jessicasillus/Compliant-Gripper/Gripper Assembly/Assem2_ref_002.SLDASM

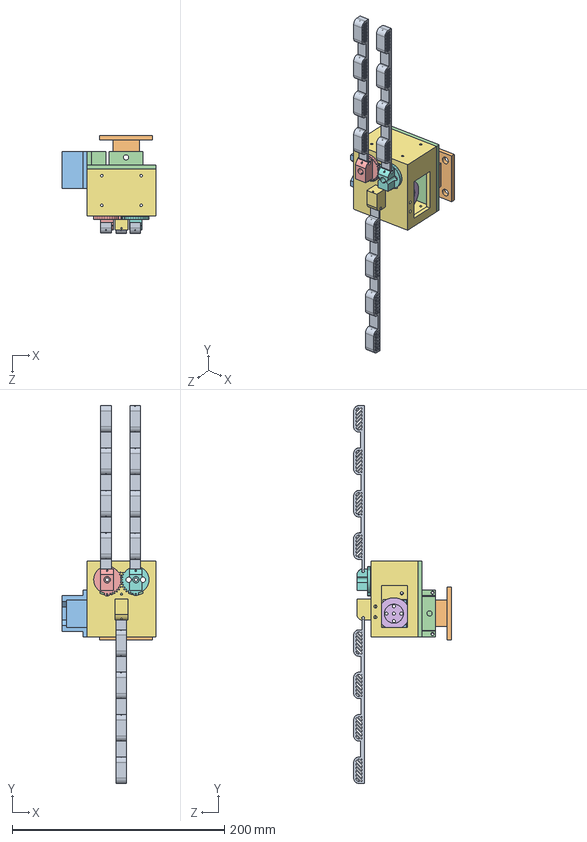
[picture p1: CAD file, 2026-03-13]
Gripper Assembly/Assem2_ref_002.SLDASM
88.6 x 356.5 x 92.1 mm
RightGear_002
Top_Box_002
Pulley_New_002
LeftGear_002
Bottom_Box_2_002
Bottom_Box_3_002
ur5eadapterplate
45degreefinger x 3
