jessicasillus/Compliant-Gripper/Gripper Assembly/RightGear_002.SLDPRT

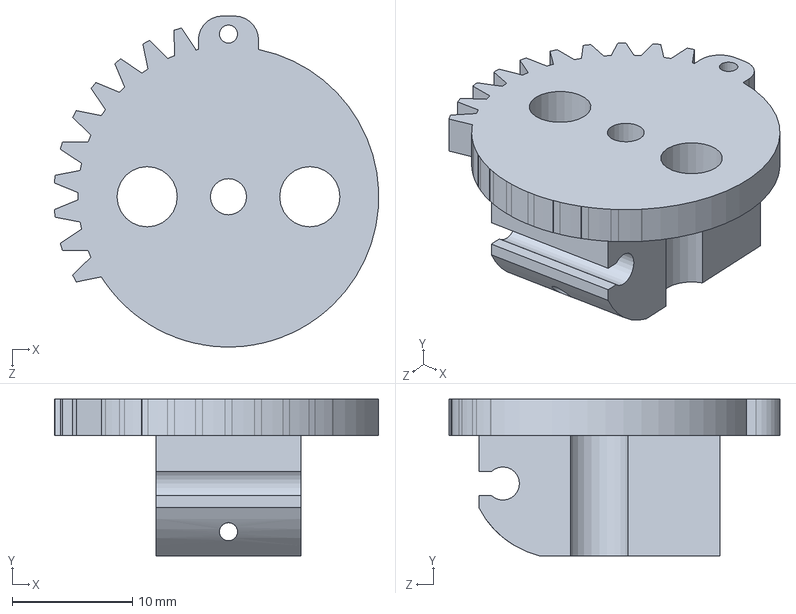
[picture p2: CAD file, 2026-03-13]
Gripper Assembly/RightGear_002.SLDPRT
26.9 x 13.0 x 27.5 mm
