jessicasillus/Compliant-Gripper/Gripper Assembly/Pulley_New_002.SLDPRT

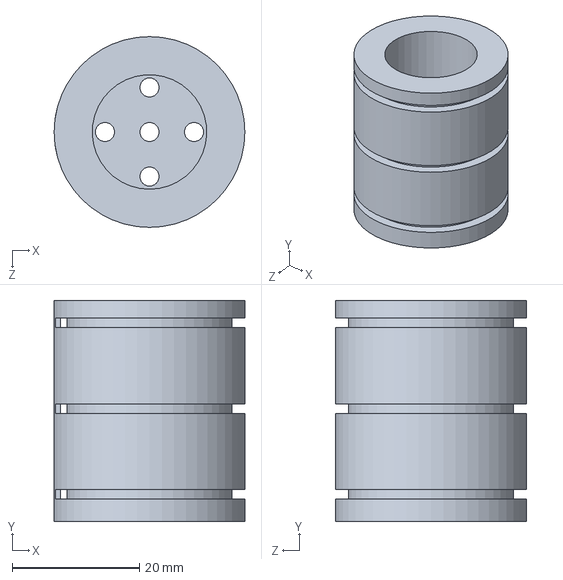
[picture p3: CAD file, 2026-03-13]
Gripper Assembly/Pulley_New_002.SLDPRT
30.0 x 34.8 x 30.0 mm
