jessicasillus/Compliant-Gripper/Gripper Assembly/45degreefinger.SLDPRT

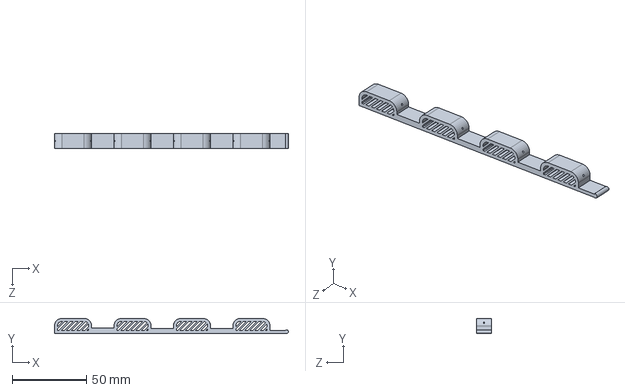
[picture p4: CAD file, 2026-03-13]
Gripper Assembly/45degreefinger.SLDPRT
157.4 x 10.2 x 10.0 mm
