jessicasillus/Compliant-Gripper/Gripper Assembly/LeftGear_002.SLDPRT

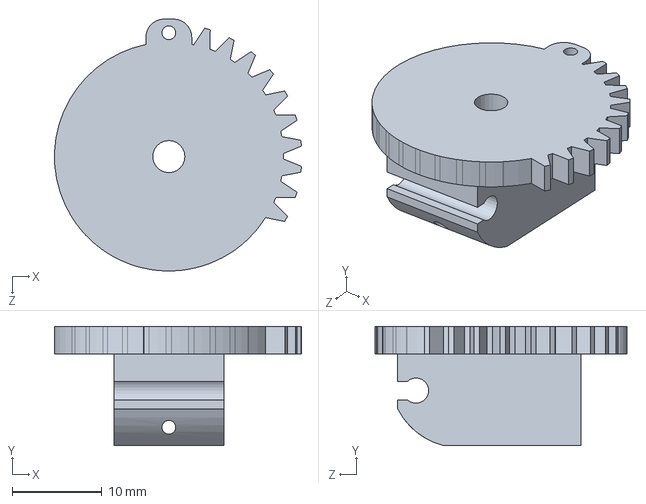
[picture p5: CAD file, 2026-03-13]
Gripper Assembly/LeftGear_002.SLDPRT
27.5 x 13.3 x 28.0 mm
