jessicasillus/Compliant-Gripper/Gripper Assembly/box_cover_002.SLDPRT

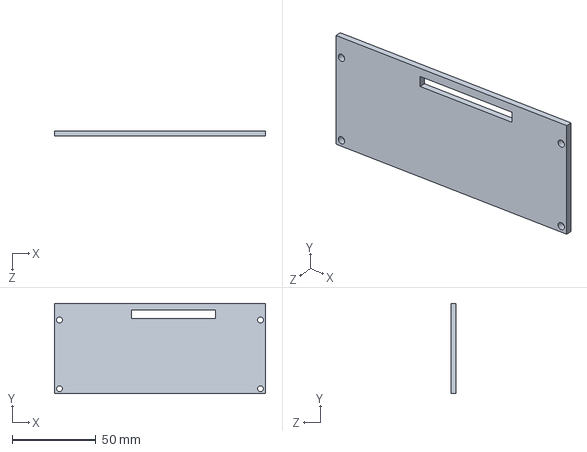
[picture p6: CAD file, 2026-03-13]
Gripper Assembly/box_cover_002.SLDPRT
126.0 x 54.0 x 3.00 mm
