jessicasillus/Compliant-Gripper/Gripper Assembly/Top_Box_002.SLDPRT

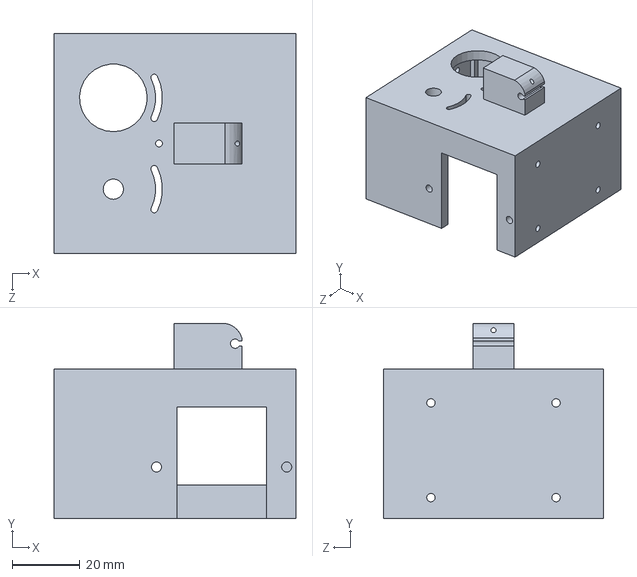
[picture p7: CAD file, 2026-03-13]
Gripper Assembly/Top_Box_002.SLDPRT
71.5 x 57.7 x 65.0 mm
