jessicasillus/Compliant-Gripper/Gripper Assembly/tendon_002.SLDPRT

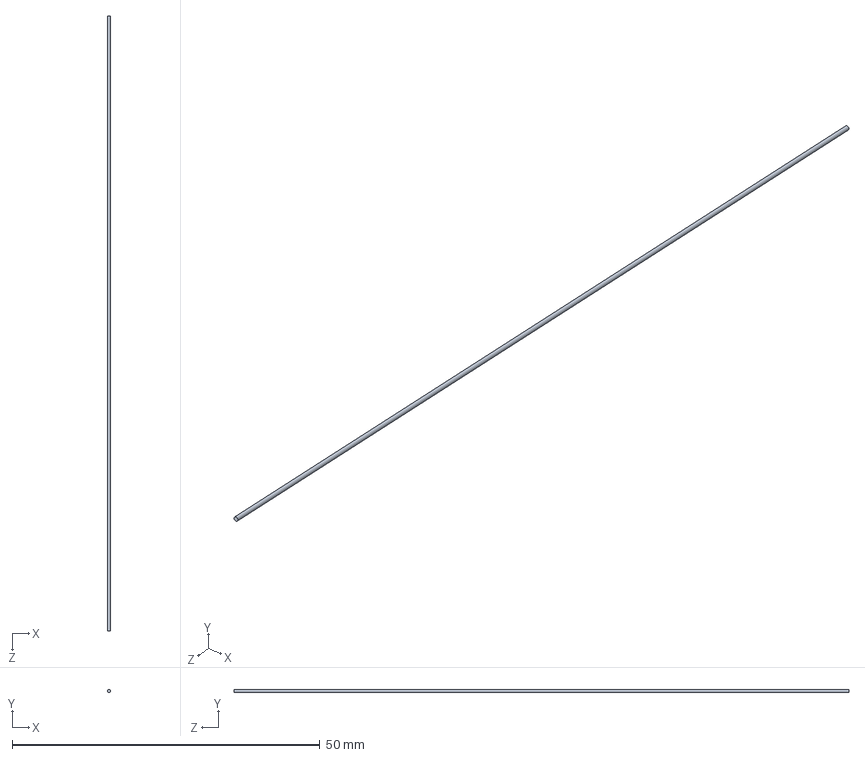
[picture p8: CAD file, 2026-03-13]
Gripper Assembly/tendon_002.SLDPRT
0.5 x 0.5 x 100.0 mm
