jessicasillus/Compliant-Gripper/Gripper Assembly/ur5eadapterplate.SLDPRT

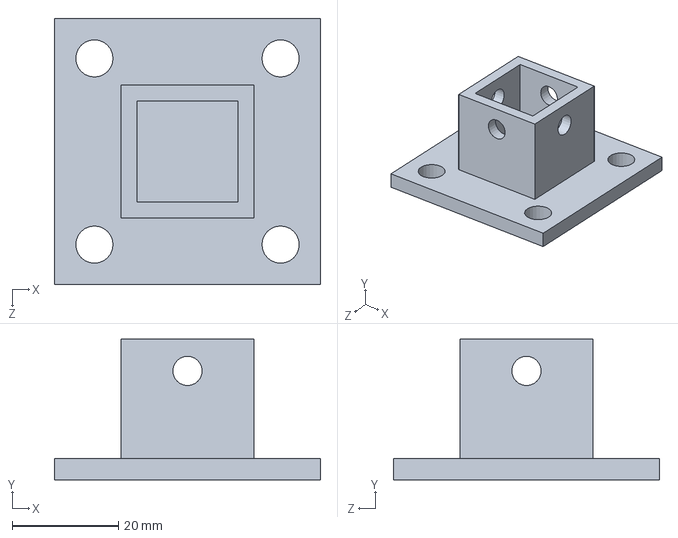
[picture p9: CAD file, 2026-03-13]
Gripper Assembly/ur5eadapterplate.SLDPRT
50.0 x 26.5 x 50.0 mm
