jessicasillus/Compliant-Gripper/Gripper Assembly/Bottom_Box_3_002.SLDPRT

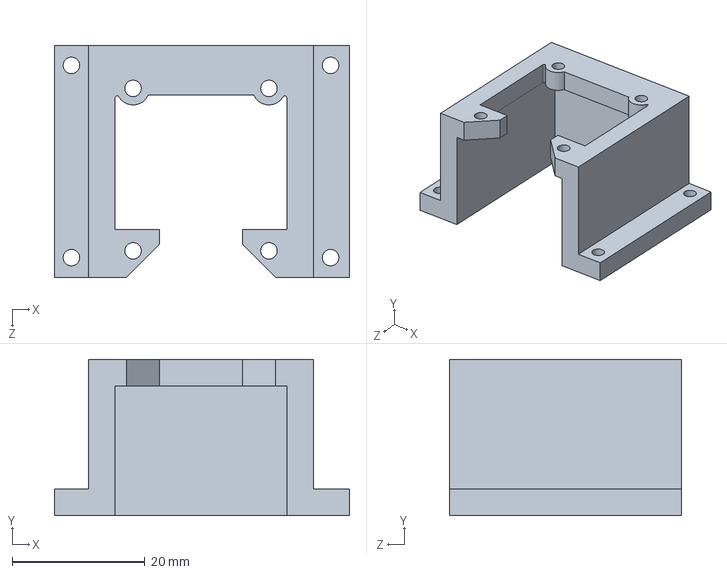
[picture p10: CAD file, 2026-03-13]
Gripper Assembly/Bottom_Box_3_002.SLDPRT
44.5 x 23.6 x 35.0 mm
