jessicasillus/Compliant-Gripper/Gripper Assembly/Bottom_Box_2_002.SLDPRT

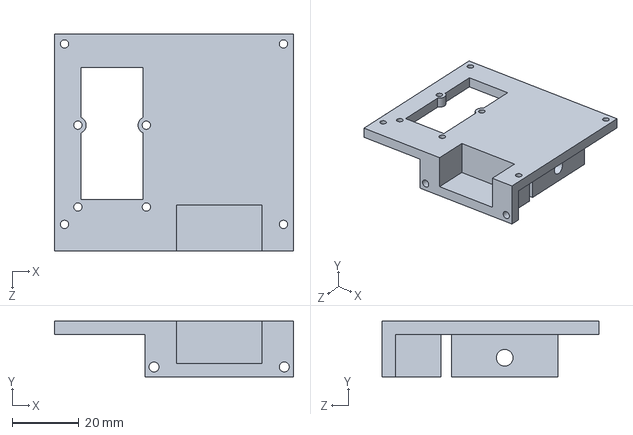
[picture p11: CAD file, 2026-03-13]
Gripper Assembly/Bottom_Box_2_002.SLDPRT
71.5 x 16.8 x 65.0 mm
