jessicasillus/Compliant-Gripper/Gripper Assembly/STS3215_03a v1_002.SLDASM

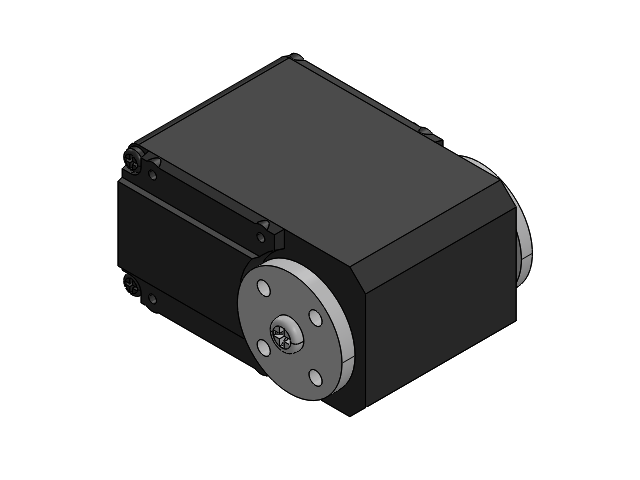
[picture p12: CAD file, 2026-03-13]
Gripper Assembly/STS3215_03a v1_002.SLDASM
ac2.step
ac1.step
main.step
