jessicasillus/Compliant-Gripper/Mujoco Simulation Scripts/ur5e_gripper.xml

<mujoco model="ur5e_3finger_gripper">
  <!--
    UR5e + 3-Finger Compliant Gripper — Pick & Place Simulation
  -->

  <compiler angle="radian" meshdir="assets" autolimits="true"/>

  <option gravity="0 0 -9.81" timestep="0.001" integrator="implicit" solver="Newton" iterations="150" cone="elliptic" noslip_iterations="3" noslip_tolerance="1e-6">
    <flag warmstart="enable"/>
  </option>

  <visual>
    <headlight ambient="0.5 0.5 0.5" diffuse="0.8 0.8 0.8"/>
    <rgba haze="0.10 0.18 0.28 1"/>
    <quality shadowsize="4096"/>
    <map znear="0.001"/>
  </visual>

  <default>
    <!-- ═══ UR5e defaults ═══ -->
    <default class="ur5e">
      <material specular="0.5" shininess="0.25"/>
      <joint axis="0 1 0" range="-6.28319 6.28319" armature="0.1"/>
      <general gaintype="fixed" biastype="affine" ctrlrange="-6.2831 6.2831" gainprm="2000" biasprm="0 -2000 -400" forcerange="-150 150"/>
      <default class="size3">
        <default class="size3_limited">
          <joint range="-3.1415 3.1415"/>
          <general ctrlrange="-3.1415 3.1415"/>
        </default>
      </default>
      <default class="size1">
        <general gainprm="500" biasprm="0 -500 -100" forcerange="-28 28"/>
      </default>
      <default class="visual">
        <geom type="mesh" contype="0" conaffinity="0" group="2"/>
      </default>
      <default class="collision">
        <geom type="capsule" group="3"/>
        <default class="eef_collision">
          <geom type="cylinder"/>
        </default>
      </default>
      <site size="0.001" rgba="0.5 0.5 0.5 0.3" group="4"/>
    </default>

    <!-- ═══ Gripper defaults ═══ -->
    <default class="finger_link">
      <geom type="box" density="1100" friction="2.8 0.8 0.02" rgba="0.88 0.55 0.10 1" contype="1" conaffinity="1" condim="6" solref="0.012 1.0" solimp="0.82 0.95 0.008" margin="0.003"/>
    </default>
    <default class="finger_joint_geom">
      <geom type="box" density="1100" contype="1" conaffinity="1" condim="6" friction="2.8 0.8 0.02" solref="0.012 1.0" solimp="0.82 0.95 0.008" margin="0.003"/>
    </default>
    <default class="palm_link">
      <geom type="box" density="1300" friction="2.8 0.8 0.02" rgba="0.82 0.50 0.12 1" contype="1" conaffinity="1" condim="6" solref="0.012 1.0" solimp="0.82 0.95 0.008" margin="0.003"/>
    </default>
    <default class="finger_joint">
      <joint type="hinge" damping="0.018" armature="1e-5" limited="true" range="0 3.14"/>
    </default>
    <default class="finger_lip">
      <geom type="sphere" density="0" contype="1" conaffinity="1" condim="6" friction="2.8 0.8 0.02" solref="0.016 1.0" solimp="0.78 0.92 0.010" rgba="0.88 0.55 0.10 0" margin="0.003"/>
    </default>
    <!-- Tray walls: thin collision-enabled boxes -->
    <default class="tray_wall">
      <geom type="box" contype="1" conaffinity="1" friction="0.8 0.3 0.01"/>
    </default>
  </default>

  <asset>
    <!-- UR5e meshes -->
    <mesh file="base_0.obj"/>
    <mesh file="base_1.obj"/>
    <mesh file="shoulder_0.obj"/>
    <mesh file="shoulder_1.obj"/>
    <mesh file="shoulder_2.obj"/>
    <mesh file="upperarm_0.obj"/>
    <mesh file="upperarm_1.obj"/>
    <mesh file="upperarm_2.obj"/>
    <mesh file="upperarm_3.obj"/>
    <mesh file="forearm_0.obj"/>
    <mesh file="forearm_1.obj"/>
    <mesh file="forearm_2.obj"/>
    <mesh file="forearm_3.obj"/>
    <mesh file="wrist1_0.obj"/>
    <mesh file="wrist1_1.obj"/>
    <mesh file="wrist1_2.obj"/>
    <mesh file="wrist2_0.obj"/>
    <mesh file="wrist2_1.obj"/>
    <mesh file="wrist2_2.obj"/>
    <mesh file="wrist3.obj"/>

    <!-- UR5e materials -->
    <material class="ur5e" name="black" rgba="0.05 0.05 0.05 1"/>
    <material class="ur5e" name="jointgray" rgba="0.30 0.30 0.30 1"/>
    <material class="ur5e" name="linkgray" rgba="0.85 0.85 0.85 1"/>
    <material class="ur5e" name="urblue" rgba="0.20 0.50 0.80 1"/>

    <!-- Scene textures/materials -->
    <texture type="skybox" builtin="gradient" rgb1="0.55 0.70 0.85" rgb2="0.12 0.12 0.20" width="512" height="3072"/>
    <texture name="grid" type="2d" builtin="checker" rgb1="0.88 0.88 0.88" rgb2="0.76 0.76 0.76" width="256" height="256"/>
    <material name="grid_mat" texture="grid" texrepeat="6 6" reflectance="0.12"/>
    <material name="table_mat" rgba="0.75 0.65 0.50 1" specular="0.15" shininess="0.15"/>
    <material name="pedestal_mat" rgba="0.35 0.35 0.38 1" specular="0.4" shininess="0.3"/>

    <!-- Gripper materials -->
    <material name="body_mat" rgba="0.78 0.78 0.80 1"/>
    <material name="body_base_mat" rgba="0.62 0.62 0.64 1"/>
    <material name="coupling_mat" rgba="0.55 0.55 0.57 1" specular="0.4"/>
    <material name="joint1_mat" rgba="0.55 0.30 0.05 1"/>
    <material name="joint2_mat" rgba="0.62 0.36 0.08 1"/>
    <material name="joint3_mat" rgba="0.70 0.42 0.10 1"/>

    <!-- Object materials -->
    <material name="object3_mat" rgba="0.85 0.25 0.25 1.0" specular="0.5" shininess="0.4"/>
    <material name="paper_towel_mat" rgba="0.95 0.93 0.88 1.0" specular="0.05"/>
    <material name="paint_tube_mat" rgba="0.10 0.10 0.10 1.0" specular="0.15"/>
    <material name="paint_tube_label_mat" rgba="0.10 0.55 0.55 1.0" specular="0.20"/>
    <material name="paint_tube_cap_mat" rgba="0.88 0.88 0.88 1.0" specular="0.40"/>
    <material name="screwdriver_handle_mat" rgba="0.85 0.18 0.18 1.0" specular="0.10"/>
    <material name="screwdriver_shaft_mat" rgba="0.80 0.80 0.82 1.0" specular="0.70"/>
    <material name="tape_roll_mat" rgba="0.78 0.66 0.29 1.0" specular="0.25"/>
    <material name="tape_core_mat" rgba="0.54 0.44 0.25 1.0" specular="0.10"/>

    <!-- Tray materials -->
    <material name="pick_tray_mat" rgba="0.30 0.65 0.35 0.85" specular="0.1"/>
    <material name="place_tray_mat" rgba="0.25 0.45 0.80 0.85" specular="0.1"/>

    <!-- Target marker -->
    <material name="target_mat" rgba="1.0 0.6 0.1 0.7" specular="0.0"/>
  </asset>

  <worldbody>
    <!-- ═══ LIGHTING ═══ -->
    <light name="main_light" pos="0.3 0.0 2.8" dir="0 0 -1" directional="true" diffuse="0.70 0.70 0.70" specular="0.3 0.3 0.3" castshadow="true"/>
    <light name="fill_light" pos="-1.0 1.0 2.0" dir="0.4 -0.3 -0.8" diffuse="0.35 0.38 0.42" castshadow="false"/>
    <light name="back_light" pos="0.8 -0.8 1.5" dir="-0.3 0.3 -0.6" diffuse="0.20 0.20 0.25" castshadow="false"/>

    <geom name="floor" size="0 0 0.05" type="plane" material="grid_mat" contype="1" conaffinity="1"/>

    <!-- ═══ WORK TABLE (expanded for more arm clearance) ═══ -->
    <geom name="table_top" type="box" pos="0.15 0.20 0.395" size="0.62 0.45 0.005" material="table_mat" contype="1" conaffinity="1" friction="1.0 0.5 0.01"/>
    <geom name="table_leg1" type="cylinder" pos="-0.42 -0.20 0.195" size="0.025 0.195" material="pedestal_mat" contype="0" conaffinity="0"/>
    <geom name="table_leg2" type="cylinder" pos="0.72 -0.20 0.195" size="0.025 0.195" material="pedestal_mat" contype="0" conaffinity="0"/>
    <geom name="table_leg3" type="cylinder" pos="-0.42 0.60 0.195" size="0.025 0.195" material="pedestal_mat" contype="0" conaffinity="0"/>
    <geom name="table_leg4" type="cylinder" pos="0.72 0.60 0.195" size="0.025 0.195" material="pedestal_mat" contype="0" conaffinity="0"/>

    <!-- ═══ PICK PEDESTAL (green) — flat platform, no walls ═══
         Centre: x=-0.22, y=0.35, top surface at z=0.500
         150×120mm footprint — fits tape roll (95mm) with margin.  -->
    <geom name="pick_pedestal" type="box" pos="-0.22 0.35 0.450" size="0.075 0.060 0.050" material="pick_tray_mat" contype="1" conaffinity="1"/>
    <geom name="pick_pedestal_top" type="box" pos="-0.22 0.35 0.5015" size="0.075 0.060 0.0015" material="pick_tray_mat" contype="1" conaffinity="1"/>

    <!-- ═══ PLACE BOX (blue) — open-top box for catching dropped objects ═══
         Centre: x=0.52, y=0.35, floor at z=0.403 (table level)
         150×120mm interior, walls 6mm thick, 60mm tall -->
    <!-- floor -->
    <geom name="place_box_floor" type="box" pos="0.52 0.35 0.4015" size="0.075 0.060 0.0015" material="place_tray_mat" contype="1" conaffinity="1"/>
    <!-- front wall (-Y) -->
    <geom name="place_box_w_front" class="tray_wall" pos="0.52 0.284 0.433" size="0.075 0.006 0.033" material="place_tray_mat"/>
    <!-- back wall (+Y) -->
    <geom name="place_box_w_back" class="tray_wall" pos="0.52 0.416 0.433" size="0.075 0.006 0.033" material="place_tray_mat"/>
    <!-- left wall (-X) -->
    <geom name="place_box_w_left" class="tray_wall" pos="0.439 0.35 0.433" size="0.006 0.066 0.033" material="place_tray_mat"/>
    <!-- right wall (+X) -->
    <geom name="place_box_w_right" class="tray_wall" pos="0.601 0.35 0.433" size="0.006 0.066 0.033" material="place_tray_mat"/>

    <!-- ═══ UR5e ARM on the table (centered between trays) ═══ -->
    <body name="base" pos="0.15 -0.05 0.40" quat="0 0 0 -1" childclass="ur5e">
      <inertial mass="4.0" pos="0 0 0" diaginertia="0.00443333156 0.00443333156 0.0072"/>
      <geom mesh="base_0" material="black" class="visual"/>
      <geom mesh="base_1" material="jointgray" class="visual"/>

      <body name="shoulder_link" pos="0 0 0.163">
        <inertial mass="3.7" pos="0 0 0" diaginertia="0.0102675 0.0102675 0.00666"/>
        <joint name="shoulder_pan_joint" class="size3" axis="0 0 1"/>
        <geom mesh="shoulder_0" material="urblue" class="visual"/>
        <geom mesh="shoulder_1" material="black" class="visual"/>
        <geom mesh="shoulder_2" material="jointgray" class="visual"/>
        <geom class="collision" size="0.06 0.06" pos="0 0 -0.04"/>

        <body name="upper_arm_link" pos="0 0.138 0" quat="1 0 1 0">
          <inertial mass="8.393" pos="0 0 0.2125" diaginertia="0.133886 0.133886 0.0151074"/>
          <joint name="shoulder_lift_joint" class="size3"/>
          <geom mesh="upperarm_0" material="linkgray" class="visual"/>
          <geom mesh="upperarm_1" material="black" class="visual"/>
          <geom mesh="upperarm_2" material="jointgray" class="visual"/>
          <geom mesh="upperarm_3" material="urblue" class="visual"/>
          <geom class="collision" pos="0 -0.04 0" quat="1 1 0 0" size="0.06 0.06"/>
          <geom class="collision" size="0.05 0.2" pos="0 0 0.2"/>

          <body name="forearm_link" pos="0 -0.131 0.425">
            <inertial mass="2.275" pos="0 0 0.196" diaginertia="0.0311796 0.0311796 0.004095"/>
            <joint name="elbow_joint" class="size3_limited"/>
            <geom mesh="forearm_0" material="urblue" class="visual"/>
            <geom mesh="forearm_1" material="linkgray" class="visual"/>
            <geom mesh="forearm_2" material="black" class="visual"/>
            <geom mesh="forearm_3" material="jointgray" class="visual"/>
            <geom class="collision" pos="0 0.08 0" quat="1 1 0 0" size="0.055 0.06"/>
            <geom class="collision" size="0.038 0.19" pos="0 0 0.2"/>

            <body name="wrist_1_link" pos="0 0 0.392" quat="1 0 1 0">
              <inertial mass="1.219" pos="0 0.127 0" diaginertia="0.0025599 0.0025599 0.0021942"/>
              <joint name="wrist_1_joint" class="size1"/>
              <geom mesh="wrist1_0" material="black" class="visual"/>
              <geom mesh="wrist1_1" material="urblue" class="visual"/>
              <geom mesh="wrist1_2" material="jointgray" class="visual"/>
              <geom class="collision" pos="0 0.05 0" quat="1 1 0 0" size="0.04 0.07"/>

              <body name="wrist_2_link" pos="0 0.127 0">
                <inertial mass="1.219" pos="0 0 0.1" diaginertia="0.0025599 0.0025599 0.0021942"/>
                <joint name="wrist_2_joint" axis="0 0 1" class="size1"/>
                <geom mesh="wrist2_0" material="black" class="visual"/>
                <geom mesh="wrist2_1" material="urblue" class="visual"/>
                <geom mesh="wrist2_2" material="jointgray" class="visual"/>
                <geom class="collision" size="0.04 0.06" pos="0 0 0.04"/>
                <geom class="collision" pos="0 0.02 0.1" quat="1 1 0 0" size="0.04 0.04"/>

                <body name="wrist_3_link" pos="0 0 0.1">
                  <inertial mass="0.1889" pos="0 0.0771683 0" quat="1 0 0 1" diaginertia="0.000132134 9.90863e-05 9.90863e-05"/>
                  <joint name="wrist_3_joint" class="size1"/>
                  <geom material="linkgray" mesh="wrist3" class="visual"/>
                  <geom class="eef_collision" pos="0 0.08 0" quat="1 1 0 0" size="0.04 0.02"/>
                  <site name="attachment_site" pos="0 0.1 0" quat="-1 1 0 0"/>

                  <body name="gripper_base" pos="0 0.153 0" quat="0.7071 -0.7071 0 0">

                    <geom name="coupling" type="cylinder" size="0.022 0.012" pos="0 0 -0.065" material="coupling_mat" contype="0" conaffinity="0"/>
                    <geom name="body_main" type="box" size="0.026 0.022 0.018" pos="0 0 -0.030" material="body_mat" contype="0" conaffinity="0"/>
                    <geom name="body_plate" type="box" size="0.033 0.030 0.005" pos="0 0 -0.053" material="body_base_mat" contype="0" conaffinity="0"/>

                    <site name="tcp" pos="0 0 0.02" size="0.005" rgba="1 0.2 0.2 0.8"/>

                    <!-- ══ FINGER A ══ -->
                    <body name="A_palm" pos="-0.014 0.012 0" euler="0 0 -1.5708">
                      <joint name="A_splay" type="hinge" axis="0 0 -1" limited="true" range="0 0.5236" damping="0.05" stiffness="0.5" armature="1e-4"/>
                      <geom name="A_palm_geom" class="palm_link" size="0.0125 0.005 0.0075" pos="0.0125 0 0"/>
                      <body name="A_link0" pos="0.025 0 0">
                        <joint name="A_j0" class="finger_joint" axis="0 -1 0" stiffness="0.05750"/>
                        <geom name="A_j0_geom" class="finger_joint_geom" material="joint1_mat" size="0.0075 0.005 0.001625" pos="0.0075 0 0"/>
                        <geom name="A_l0_geom" class="finger_link" size="0.0125 0.005 0.006" pos="0.0275 0 0"/>
                        <geom name="A_l0_lip_a" class="finger_lip" pos="0.033 0 0.007" size="0.002"/>
                        <geom name="A_l0_lip_b" class="finger_lip" pos="0.033 0 -0.007" size="0.002"/>
                        <geom name="A_l0_lip_c" class="finger_lip" pos="0.0225 0 0.007" size="0.002"/>
                        <geom name="A_l0_lip_d" class="finger_lip" pos="0.0225 0 -0.007" size="0.002"/>
                        <body name="A_link1" pos="0.040 0 0">
                          <joint name="A_j1" class="finger_joint" axis="0 -1 0" stiffness="0.05750"/>
                          <geom name="A_j1_geom" class="finger_joint_geom" material="joint1_mat" size="0.0075 0.005 0.001625" pos="0.0075 0 0"/>
                          <geom name="A_l1_geom" class="finger_link" size="0.0125 0.005 0.006" pos="0.0275 0 0"/>
                          <geom name="A_l1_lip_a" class="finger_lip" pos="0.033 0 0.007" size="0.002"/>
                          <geom name="A_l1_lip_b" class="finger_lip" pos="0.033 0 -0.007" size="0.002"/>
                          <geom name="A_l1_lip_c" class="finger_lip" pos="0.0225 0 0.007" size="0.002"/>
                          <geom name="A_l1_lip_d" class="finger_lip" pos="0.0225 0 -0.007" size="0.002"/>
                          <site name="A_force1" pos="0.0275 0 0.012" size="0.008" rgba="1 0 0 0"/>
                          <body name="A_link2" pos="0.040 0 0">
                            <joint name="A_j2" class="finger_joint" axis="0 -1 0" stiffness="0.05750"/>
                            <geom name="A_j2_geom" class="finger_joint_geom" material="joint2_mat" size="0.0075 0.005 0.001625" pos="0.0075 0 0"/>
                            <geom name="A_l2_geom" class="finger_link" size="0.0125 0.005 0.006" pos="0.0275 0 0"/>
                            <geom name="A_l2_lip_a" class="finger_lip" pos="0.033 0 0.007" size="0.002"/>
                            <geom name="A_l2_lip_b" class="finger_lip" pos="0.033 0 -0.007" size="0.002"/>
                            <geom name="A_l2_lip_c" class="finger_lip" pos="0.0225 0 0.007" size="0.002"/>
                            <geom name="A_l2_lip_d" class="finger_lip" pos="0.0225 0 -0.007" size="0.002"/>
                            <site name="A_force2" pos="0.0275 0 0.012" size="0.008" rgba="1 0 0 0"/>
                            <body name="A_link3" pos="0.040 0 0">
                              <joint name="A_j3" class="finger_joint" axis="0 -1 0" stiffness="0.07182"/>
                              <geom name="A_j3_geom" class="finger_joint_geom" material="joint3_mat" size="0.0075 0.005 0.00175" pos="0.0075 0 0"/>
                              <geom name="A_l3_geom" class="finger_link" size="0.0125 0.005 0.006" pos="0.0275 0 0"/>
                              <geom name="A_l3_lip_a" class="finger_lip" pos="0.033 0 0.007" size="0.002"/>
                              <geom name="A_l3_lip_b" class="finger_lip" pos="0.033 0 -0.007" size="0.002"/>
                              <geom name="A_l3_lip_c" class="finger_lip" pos="0.0225 0 0.007" size="0.002"/>
                              <geom name="A_l3_lip_d" class="finger_lip" pos="0.0225 0 -0.007" size="0.002"/>
                              <site name="A_force3" pos="0.0275 0 0.012" size="0.008" rgba="1 0 0 0"/>
                              <site name="A_tip" pos="0.040 0 0" size="0.003" rgba="0.95 0.25 0.2 1"/>
                            </body>
                          </body>
                        </body>
                      </body>
                    </body>

                    <!-- ══ FINGER B ══ -->
                    <body name="B_palm" pos="0.014 0.012 0" euler="0 0 -1.5708">
                      <joint name="B_splay" type="hinge" axis="0 0 1" limited="true" range="0 0.5236" damping="0.05" stiffness="0.5" armature="1e-4"/>
                      <geom name="B_palm_geom" class="palm_link" size="0.0125 0.005 0.0075" pos="0.0125 0 0"/>
                      <body name="B_link0" pos="0.025 0 0">
                        <joint name="B_j0" class="finger_joint" axis="0 -1 0" stiffness="0.05750"/>
                        <geom name="B_j0_geom" class="finger_joint_geom" material="joint1_mat" size="0.0075 0.005 0.001625" pos="0.0075 0 0"/>
                        <geom name="B_l0_geom" class="finger_link" size="0.0125 0.005 0.006" pos="0.0275 0 0"/>
                        <geom name="B_l0_lip_a" class="finger_lip" pos="0.033 0 0.007" size="0.002"/>
                        <geom name="B_l0_lip_b" class="finger_lip" pos="0.033 0 -0.007" size="0.002"/>
                        <geom name="B_l0_lip_c" class="finger_lip" pos="0.0225 0 0.007" size="0.002"/>
                        <geom name="B_l0_lip_d" class="finger_lip" pos="0.0225 0 -0.007" size="0.002"/>
                        <body name="B_link1" pos="0.040 0 0">
                          <joint name="B_j1" class="finger_joint" axis="0 -1 0" stiffness="0.05750"/>
                          <geom name="B_j1_geom" class="finger_joint_geom" material="joint1_mat" size="0.0075 0.005 0.001625" pos="0.0075 0 0"/>
                          <geom name="B_l1_geom" class="finger_link" size="0.0125 0.005 0.006" pos="0.0275 0 0"/>
                          <geom name="B_l1_lip_a" class="finger_lip" pos="0.033 0 0.007" size="0.002"/>
                          <geom name="B_l1_lip_b" class="finger_lip" pos="0.033 0 -0.007" size="0.002"/>
                          <geom name="B_l1_lip_c" class="finger_lip" pos="0.0225 0 0.007" size="0.002"/>
                          <geom name="B_l1_lip_d" class="finger_lip" pos="0.0225 0 -0.007" size="0.002"/>
                          <site name="B_force1" pos="0.0275 0 0.012" size="0.008" rgba="1 0 0 0"/>
                          <body name="B_link2" pos="0.040 0 0">
                            <joint name="B_j2" class="finger_joint" axis="0 -1 0" stiffness="0.05750"/>
                            <geom name="B_j2_geom" class="finger_joint_geom" material="joint2_mat" size="0.0075 0.005 0.001625" pos="0.0075 0 0"/>
                            <geom name="B_l2_geom" class="finger_link" size="0.0125 0.005 0.006" pos="0.0275 0 0"/>
                            <geom name="B_l2_lip_a" class="finger_lip" pos="0.033 0 0.007" size="0.002"/>
                            <geom name="B_l2_lip_b" class="finger_lip" pos="0.033 0 -0.007" size="0.002"/>
                            <geom name="B_l2_lip_c" class="finger_lip" pos="0.0225 0 0.007" size="0.002"/>
                            <geom name="B_l2_lip_d" class="finger_lip" pos="0.0225 0 -0.007" size="0.002"/>
                            <site name="B_force2" pos="0.0275 0 0.012" size="0.008" rgba="1 0 0 0"/>
                            <body name="B_link3" pos="0.040 0 0">
                              <joint name="B_j3" class="finger_joint" axis="0 -1 0" stiffness="0.07182"/>
                              <geom name="B_j3_geom" class="finger_joint_geom" material="joint3_mat" size="0.0075 0.005 0.00175" pos="0.0075 0 0"/>
                              <geom name="B_l3_geom" class="finger_link" size="0.0125 0.005 0.006" pos="0.0275 0 0"/>
                              <geom name="B_l3_lip_a" class="finger_lip" pos="0.033 0 0.007" size="0.002"/>
                              <geom name="B_l3_lip_b" class="finger_lip" pos="0.033 0 -0.007" size="0.002"/>
                              <geom name="B_l3_lip_c" class="finger_lip" pos="0.0225 0 0.007" size="0.002"/>
                              <geom name="B_l3_lip_d" class="finger_lip" pos="0.0225 0 -0.007" size="0.002"/>
                              <site name="B_force3" pos="0.0275 0 0.012" size="0.008" rgba="1 0 0 0"/>
                              <site name="B_tip" pos="0.040 0 0" size="0.003" rgba="0.95 0.25 0.2 1"/>
                            </body>
                          </body>
                        </body>
                      </body>
                    </body>

                    <!-- ══ FINGER C (opposing) ══ -->
                    <body name="C_palm" pos="0 -0.012 0" euler="0 0 1.5708">
                      <geom name="C_palm_geom" class="palm_link" size="0.0125 0.005 0.0075" pos="0.0125 0 0"/>
                      <body name="C_link0" pos="0.025 0 0">
                        <joint name="C_j0" class="finger_joint" axis="0 -1 0" stiffness="0.05750"/>
                        <geom name="C_j0_geom" class="finger_joint_geom" material="joint1_mat" size="0.0075 0.005 0.001625" pos="0.0075 0 0"/>
                        <geom name="C_l0_geom" class="finger_link" size="0.0125 0.005 0.006" pos="0.0275 0 0"/>
                        <geom name="C_l0_lip_a" class="finger_lip" pos="0.033 0 0.007" size="0.002"/>
                        <geom name="C_l0_lip_b" class="finger_lip" pos="0.033 0 -0.007" size="0.002"/>
                        <geom name="C_l0_lip_c" class="finger_lip" pos="0.0225 0 0.007" size="0.002"/>
                        <geom name="C_l0_lip_d" class="finger_lip" pos="0.0225 0 -0.007" size="0.002"/>
                        <body name="C_link1" pos="0.040 0 0">
                          <joint name="C_j1" class="finger_joint" axis="0 -1 0" stiffness="0.05750"/>
                          <geom name="C_j1_geom" class="finger_joint_geom" material="joint1_mat" size="0.0075 0.005 0.001625" pos="0.0075 0 0"/>
                          <geom name="C_l1_geom" class="finger_link" size="0.0125 0.005 0.006" pos="0.0275 0 0"/>
                          <geom name="C_l1_lip_a" class="finger_lip" pos="0.033 0 0.007" size="0.002"/>
                          <geom name="C_l1_lip_b" class="finger_lip" pos="0.033 0 -0.007" size="0.002"/>
                          <geom name="C_l1_lip_c" class="finger_lip" pos="0.0225 0 0.007" size="0.002"/>
                          <geom name="C_l1_lip_d" class="finger_lip" pos="0.0225 0 -0.007" size="0.002"/>
                          <site name="C_force1" pos="0.0275 0 0.012" size="0.008" rgba="1 0 0 0"/>
                          <body name="C_link2" pos="0.040 0 0">
                            <joint name="C_j2" class="finger_joint" axis="0 -1 0" stiffness="0.05750"/>
                            <geom name="C_j2_geom" class="finger_joint_geom" material="joint2_mat" size="0.0075 0.005 0.001625" pos="0.0075 0 0"/>
                            <geom name="C_l2_geom" class="finger_link" size="0.0125 0.005 0.006" pos="0.0275 0 0"/>
                            <geom name="C_l2_lip_a" class="finger_lip" pos="0.033 0 0.007" size="0.002"/>
                            <geom name="C_l2_lip_b" class="finger_lip" pos="0.033 0 -0.007" size="0.002"/>
                            <geom name="C_l2_lip_c" class="finger_lip" pos="0.0225 0 0.007" size="0.002"/>
                            <geom name="C_l2_lip_d" class="finger_lip" pos="0.0225 0 -0.007" size="0.002"/>
                            <site name="C_force2" pos="0.0275 0 0.012" size="0.008" rgba="1 0 0 0"/>
                            <body name="C_link3" pos="0.040 0 0">
                              <joint name="C_j3" class="finger_joint" axis="0 -1 0" stiffness="0.07182"/>
                              <geom name="C_j3_geom" class="finger_joint_geom" material="joint3_mat" size="0.0075 0.005 0.00175" pos="0.0075 0 0"/>
                              <geom name="C_l3_geom" class="finger_link" size="0.0125 0.005 0.006" pos="0.0275 0 0"/>
                              <geom name="C_l3_lip_a" class="finger_lip" pos="0.033 0 0.007" size="0.002"/>
                              <geom name="C_l3_lip_b" class="finger_lip" pos="0.033 0 -0.007" size="0.002"/>
                              <geom name="C_l3_lip_c" class="finger_lip" pos="0.0225 0 0.007" size="0.002"/>
                              <geom name="C_l3_lip_d" class="finger_lip" pos="0.0225 0 -0.007" size="0.002"/>
                              <site name="C_force3" pos="0.0275 0 0.012" size="0.008" rgba="1 0 0 0"/>
                              <site name="C_tip" pos="0.040 0 0" size="0.003" rgba="0.95 0.25 0.2 1"/>
                            </body>
                          </body>
                        </body>
                      </body>
                    </body>

                  </body> <!-- /gripper_base -->
                </body> <!-- /wrist_3_link -->
              </body> <!-- /wrist_2_link -->
            </body> <!-- /wrist_1_link -->
          </body> <!-- /forearm_link -->
        </body> <!-- /upper_arm_link -->
      </body> <!-- /shoulder_link -->
    </body> <!-- /base -->

    <!-- ═══ GRASPABLE OBJECTS — start in the PICK TRAY ═══ -->
    <!-- Pick tray centre: x=-0.22, y=0.35. Objects spread within ±60mm x, ±50mm y -->

    <!-- Sphere (Ø32mm) -->
    <body name="obj_sphere" pos="-0.22 0.35 0.518">
      <freejoint name="obj_sphere_jnt"/>
      <geom name="obj_sphere_geom" type="sphere" size="0.016" density="800" material="object3_mat" friction="1.2 0.5 0.01" contype="1" conaffinity="1" condim="6" solref="0.005 1.0"/>
    </body>

    <!-- Paint Tube (horizontal) -->
    <body name="obj_paint_tube" pos="-0.22 0.35 0.519" euler="0 1.5708 0">
      <freejoint name="obj_paint_tube_jnt"/>
      <geom name="obj_pt_body" type="cylinder" size="0.017 0.055" density="900" material="paint_tube_mat" friction="1.1 0.5 0.01" contype="1" conaffinity="1" condim="6" solref="0.008 1.0" solimp="0.92 0.98 0.001"/>
      <geom name="obj_pt_label" type="cylinder" size="0.0173 0.022" pos="0 0 -0.005" density="0" material="paint_tube_label_mat" contype="0" conaffinity="0"/>
      <geom name="obj_pt_crimp" type="box" size="0.0015 0.015 0.005" pos="0 0 -0.059" density="1200" material="paint_tube_mat" contype="0" conaffinity="0"/>
      <geom name="obj_pt_shoulder" type="cylinder" size="0.011 0.006" pos="0 0 0.061" density="900" material="paint_tube_mat" contype="0" conaffinity="0"/>
      <geom name="obj_pt_nozzle" type="cylinder" size="0.005 0.005" pos="0 0 0.072" density="900" material="paint_tube_mat" contype="0" conaffinity="0"/>
      <geom name="obj_pt_cap" type="cylinder" size="0.0075 0.005" pos="0 0 0.082" density="900" material="paint_tube_cap_mat" contype="0" conaffinity="0"/>
    </body>

    <!-- Screwdriver (horizontal) -->
    <body name="obj_screwdriver" pos="-0.22 0.35 0.515" euler="0 1.5708 0">
      <freejoint name="obj_screwdriver_jnt"/>
      <geom name="obj_sd_handle" type="cylinder" size="0.0127 0.025" density="1100" material="screwdriver_handle_mat" friction="1.8 0.8 0.01" contype="1" conaffinity="1" condim="6" solref="0.008 1.0" solimp="0.92 0.98 0.001"/>
      <geom name="obj_sd_grip" type="cylinder" size="0.014 0.002" pos="0 0 -0.005" density="0" material="screwdriver_handle_mat" contype="0" conaffinity="0"/>
      <geom name="obj_sd_ferrule" type="cylinder" size="0.006 0.004" pos="0 0 0.029" density="7800" material="screwdriver_shaft_mat" friction="0.8 0.3 0.01" contype="1" conaffinity="1" condim="6" solref="0.005 1.0"/>
      <geom name="obj_sd_shaft" type="cylinder" size="0.0015 0.031" pos="0 0 0.064" density="7800" material="screwdriver_shaft_mat" friction="0.8 0.3 0.01" contype="1" conaffinity="1" condim="6" solref="0.005 1.0"/>
    </body>

    <!-- Tape Roll (upright) -->
    <body name="obj_tape_roll" pos="-0.22 0.35 0.5254">
      <freejoint name="obj_tape_roll_jnt"/>
      <geom name="obj_tr_outer" type="cylinder" size="0.047625 0.0254" density="600" material="tape_roll_mat" friction="1.4 0.6 0.01" contype="1" conaffinity="1" condim="6" solref="0.008 1.0" solimp="0.92 0.98 0.001"/>
      <geom name="obj_tr_core" type="cylinder" size="0.0381 0.0255" density="0" material="tape_core_mat" contype="0" conaffinity="0"/>
    </body>

    <!-- Paper Towel Roll (vertical/upright) -->
    <body name="obj_paper_roll" pos="-0.22 0.35 0.605">
      <freejoint name="obj_paper_roll_jnt"/>
      <geom name="obj_paper_roll_geom" type="cylinder" size="0.0356 0.1016" density="80" material="paper_towel_mat" friction="1.2 0.5 0.01" contype="1" conaffinity="1" condim="6" solref="0.020 1.0" solimp="0.85 0.95 0.004" margin="0.001"/>
    </body>

    <!-- Target marker (IK visualiser) -->
    <body name="target_marker" pos="0.15 0.20 0.55" mocap="true">
      <geom name="target_geom" type="sphere" size="0.012" material="target_mat" contype="0" conaffinity="0"/>
      <geom name="target_x" type="cylinder" size="0.002 0.018" pos="0.018 0 0" euler="0 1.5708 0" rgba="1 0.2 0.2 0.7" contype="0" conaffinity="0"/>
      <geom name="target_y" type="cylinder" size="0.002 0.018" pos="0 0.018 0" euler="1.5708 0 0" rgba="0.2 1 0.2 0.7" contype="0" conaffinity="0"/>
      <geom name="target_z" type="cylinder" size="0.002 0.018" pos="0 0 0.018" rgba="0.2 0.2 1 0.7" contype="0" conaffinity="0"/>
    </body>

  </worldbody>

  <!-- ═══ TENDONS ═══ -->
  <tendon>
    <fixed name="tendon_A" limited="true" range="0 0.090">
      <joint joint="A_j0" coef="0.0050"/>
      <joint joint="A_j1" coef="0.0050"/>
      <joint joint="A_j2" coef="0.0050"/>
      <joint joint="A_j3" coef="0.0050"/>
    </fixed>
    <fixed name="tendon_B" limited="true" range="0 0.090">
      <joint joint="B_j0" coef="0.0050"/>
      <joint joint="B_j1" coef="0.0050"/>
      <joint joint="B_j2" coef="0.0050"/>
      <joint joint="B_j3" coef="0.0050"/>
    </fixed>
    <fixed name="tendon_C" limited="true" range="0 0.090">
      <joint joint="C_j0" coef="0.0050"/>
      <joint joint="C_j1" coef="0.0050"/>
      <joint joint="C_j2" coef="0.0050"/>
      <joint joint="C_j3" coef="0.0050"/>
    </fixed>
  </tendon>

  <!-- ═══ ACTUATORS ═══ -->
  <actuator>
    <general class="size3" name="shoulder_pan" joint="shoulder_pan_joint"/>
    <general class="size3" name="shoulder_lift" joint="shoulder_lift_joint"/>
    <general class="size3_limited" name="elbow" joint="elbow_joint"/>
    <general class="size1" name="wrist_1" joint="wrist_1_joint"/>
    <general class="size1" name="wrist_2" joint="wrist_2_joint"/>
    <general class="size1" name="wrist_3" joint="wrist_3_joint"/>

    <position name="act_A_pos" tendon="tendon_A" kp="2000" kv="50" ctrlrange="0 0.090" forcerange="-20 20"/>
    <position name="act_B_pos" tendon="tendon_B" kp="2000" kv="50" ctrlrange="0 0.090" forcerange="-20 20"/>
    <position name="act_C_pos" tendon="tendon_C" kp="2000" kv="50" ctrlrange="0 0.090" forcerange="-20 20"/>
    <general name="act_A_frc" tendon="tendon_A" gainprm="1 0 0" biasprm="0 0 0" ctrlrange="-10 10" forcerange="-20 20" dyntype="none"/>
    <general name="act_B_frc" tendon="tendon_B" gainprm="1 0 0" biasprm="0 0 0" ctrlrange="-10 10" forcerange="-20 20" dyntype="none"/>
    <general name="act_C_frc" tendon="tendon_C" gainprm="1 0 0" biasprm="0 0 0" ctrlrange="-10 10" forcerange="-20 20" dyntype="none"/>
    <position name="act_A_splay" joint="A_splay" kp="500" kv="20" ctrlrange="0 0.5236" forcerange="-10 10"/>
    <position name="act_B_splay" joint="B_splay" kp="500" kv="20" ctrlrange="0 0.5236" forcerange="-10 10"/>
  </actuator>

  <!-- ═══ SENSORS ═══ -->
  <sensor>
    <jointpos name="A_j0_pos" joint="A_j0"/>
    <jointpos name="A_j1_pos" joint="A_j1"/>
    <jointpos name="A_j2_pos" joint="A_j2"/>
    <jointpos name="A_j3_pos" joint="A_j3"/>
    <jointpos name="B_j0_pos" joint="B_j0"/>
    <jointpos name="B_j1_pos" joint="B_j1"/>
    <jointpos name="B_j2_pos" joint="B_j2"/>
    <jointpos name="B_j3_pos" joint="B_j3"/>
    <jointpos name="C_j0_pos" joint="C_j0"/>
    <jointpos name="C_j1_pos" joint="C_j1"/>
    <jointpos name="C_j2_pos" joint="C_j2"/>
    <jointpos name="C_j3_pos" joint="C_j3"/>
    <tendonpos name="ten_A_len" tendon="tendon_A"/>
    <tendonpos name="ten_B_len" tendon="tendon_B"/>
    <tendonpos name="ten_C_len" tendon="tendon_C"/>
    <touch name="A_touch1" site="A_force1"/>
    <touch name="A_touch2" site="A_force2"/>
    <touch name="A_touch3" site="A_force3"/>
    <touch name="B_touch1" site="B_force1"/>
    <touch name="B_touch2" site="B_force2"/>
    <touch name="B_touch3" site="B_force3"/>
    <touch name="C_touch1" site="C_force1"/>
    <touch name="C_touch2" site="C_force2"/>
    <touch name="C_touch3" site="C_force3"/>
  </sensor>

  <!-- ═══ CONTACT EXCLUSIONS ═══ -->
  <contact>
    <exclude body1="A_palm" body2="A_link0"/>
    <exclude body1="A_link0" body2="A_link1"/>
    <exclude body1="A_link1" body2="A_link2"/>
    <exclude body1="A_link2" body2="A_link3"/>
    <exclude body1="B_palm" body2="B_link0"/>
    <exclude body1="B_link0" body2="B_link1"/>
    <exclude body1="B_link1" body2="B_link2"/>
    <exclude body1="B_link2" body2="B_link3"/>
    <exclude body1="C_palm" body2="C_link0"/>
    <exclude body1="C_link0" body2="C_link1"/>
    <exclude body1="C_link1" body2="C_link2"/>
    <exclude body1="C_link2" body2="C_link3"/>
    <exclude body1="gripper_base" body2="A_palm"/>
    <exclude body1="gripper_base" body2="B_palm"/>
    <exclude body1="gripper_base" body2="C_palm"/>
    <exclude body1="gripper_base" body2="A_link0"/>
    <exclude body1="gripper_base" body2="B_link0"/>
    <exclude body1="gripper_base" body2="C_link0"/>
    <exclude body1="gripper_base" body2="A_link1"/>
    <exclude body1="gripper_base" body2="B_link1"/>
    <exclude body1="gripper_base" body2="C_link1"/>
    <exclude body1="A_palm" body2="B_palm"/>
    <exclude body1="A_palm" body2="C_palm"/>
    <exclude body1="B_palm" body2="C_palm"/>
    <exclude body1="A_link0" body2="B_link0"/>
    <exclude body1="A_link0" body2="C_link0"/>
    <exclude body1="B_link0" body2="C_link0"/>
    <exclude body1="wrist_3_link" body2="gripper_base"/>
    <exclude body1="wrist_3_link" body2="A_palm"/>
    <exclude body1="wrist_3_link" body2="B_palm"/>
    <exclude body1="wrist_3_link" body2="C_palm"/>
    <exclude body1="wrist_2_link" body2="gripper_base"/>
  </contact>

  <!-- ═══ KEYFRAMES ═══ -->
  <keyframe>
    <key name="home" qpos="-1.5708 -1.5708 1.5708 1.5708 1.5708 0" ctrl="-1.5708 -1.5708 1.5708 1.5708 1.5708 0 0 0 0 0 0 0 0 0"/>
  </keyframe>

</mujoco>
