jessicasillus/Compliant-Gripper/(commit log)

2026-03-13 Solidworks Files for Complaint Gripper
    All files for compliant tendon-driven gripper assembly. Uses TPU fingers rather than rigid linkages.
    [45degreefinger.SLDPRT, Assem2_ref_002.SLDASM, Bottom_Box_2_002.SLDPRT, Bottom_Box_3_002.SLDPRT, LeftGear_002.SLDPRT, Pulley_New_002.SLDPRT, RightGear_002.SLDPRT, STS3215_03a v1_002.SLDASM]
2026-03-13 Python DAQ and Sensor Calibration Files
    DAQ tool and calibration tool for sensor data.
2026-03-13 Add files via upload
    ESP32 code for using MPR121 (Sensor data acquisition circuit)
2026-03-13 KiCAD PCB Design
2026-03-13 PCB Design KiCAD Files
    [PCB_V2.kicad_pcb, PCB_V2.kicad_sch, PCB_V3.kicad_pcb, PCB_V3.kicad_sch]
2026-03-31 Add README with project overview and structure
    Added comprehensive documentation for the Compliant Gripper project, detailing repository structure, CAD files, PCB files, firmware, data acquisition tools, simulations, and licensing information.
